hackzone/tgl18-badge/README.md

# tgl18-badge
Tweakers Gaming Live has an awesome event badge you can use to turn everyday objects into a game controller! HackZone has designed and produced (by hand!) a badge for all LAN visitors.

## Information
Check out our [wiki](https://github.com/hackzone/tgl18-badge/wiki) for more information about your cool new badge!

#### Names & things
The Tweakers name and logo are registered trademarks of Persgroup Online Services, all rights reserved.
