hackzone/tgl18-badge/graphics/dxf/TGL18_Badge_full_circle_75.dxf

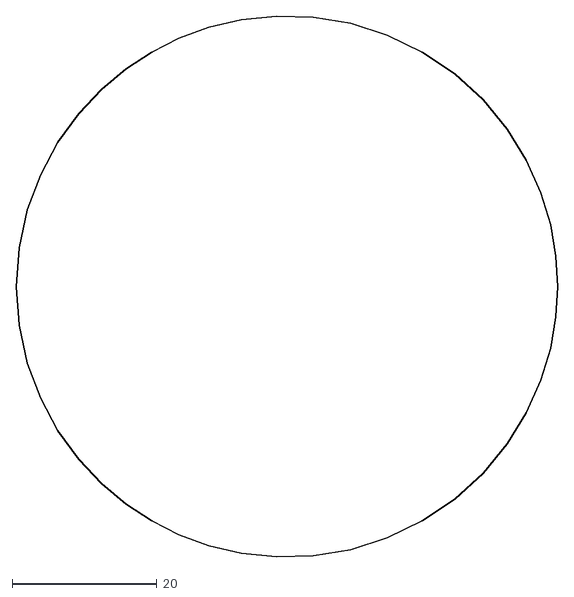
[picture p1: CAD file, 2018-10-01]
graphics/dxf/TGL18_Badge_full_circle_75.dxf
74.9 x 74.8
