hackzone/tgl18-badge/graphics/dxf/TGL18_Badge_full_circle.dxf

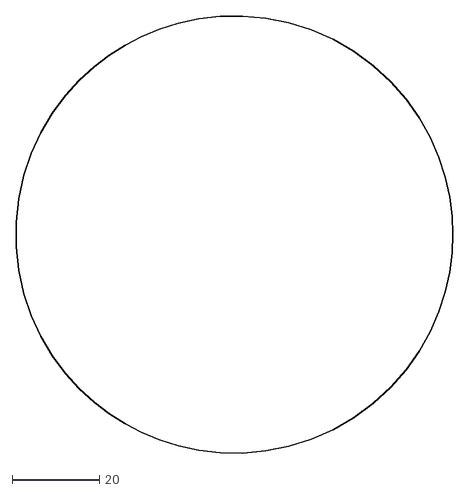
[picture p2: CAD file, 2018-10-01]
graphics/dxf/TGL18_Badge_full_circle.dxf
99.9 x 99.9
