hackzone/tgl18-badge/graphics/dxf/TGL18_Badge_T_75.dxf

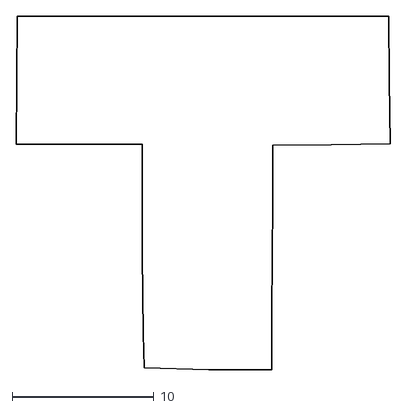
[picture p3: CAD file, 2018-10-01]
graphics/dxf/TGL18_Badge_T_75.dxf
26.3 x 24.9
