hackzone/tgl18-badge/graphics/dxf/TGL18_Badge_CU_75.dxf

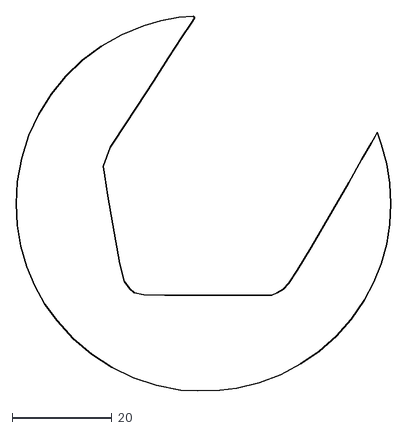
[picture p4: CAD file, 2018-10-01]
graphics/dxf/TGL18_Badge_CU_75.dxf
75.0 x 75.0
