hackzone/tgl18-badge/graphics/dxf/TGL18_Badge_T_Cutout.dxf

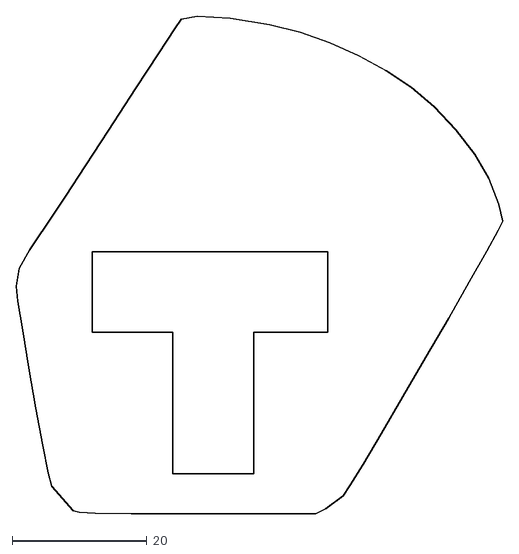
[picture p5: CAD file, 2018-10-01]
graphics/dxf/TGL18_Badge_T_Cutout.dxf
72.2 x 73.9
