hackzone/tgl18-badge/graphics/dxf/TGL18_Badge_CU.dxf

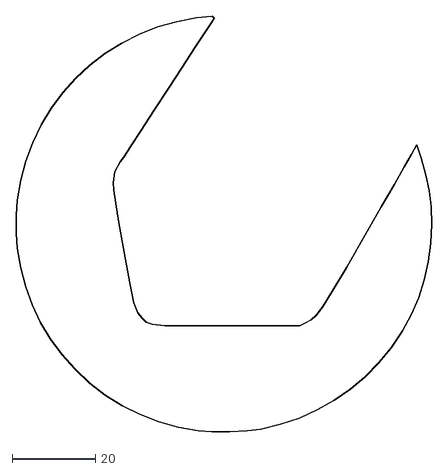
[picture p6: CAD file, 2018-10-01]
graphics/dxf/TGL18_Badge_CU.dxf
100.0 x 100.0
