hackzone/tgl18-badge/graphics/dxf/TGL18_Badge_Black_bit.dxf

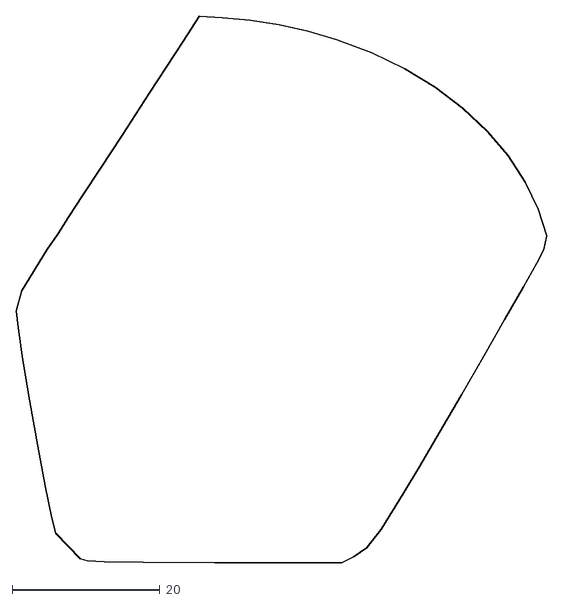
[picture p7: CAD file, 2018-10-01]
graphics/dxf/TGL18_Badge_Black_bit.dxf
71.8 x 73.9
