hackzone/tgl18-badge/graphics/dxf/TGL18_Badge_T.dxf

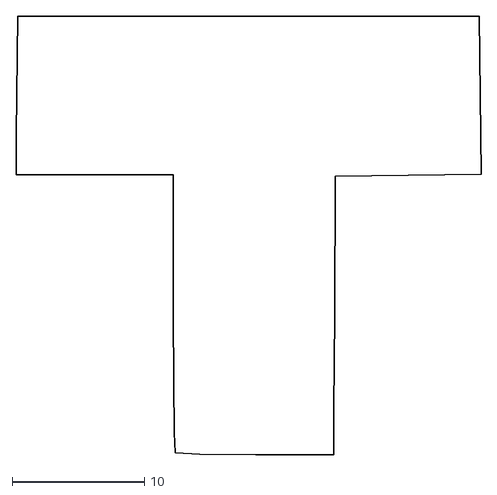
[picture p8: CAD file, 2018-10-01]
graphics/dxf/TGL18_Badge_T.dxf
35.1 x 33.2
