hackzone/tgl18-badge/(commit log)

2018-09-30 Added logic level converter and mpr121 schematics and layout
    [_saved_tgl18-badge.sch, tgl18-badge.kicad_pcb]
2018-09-30 Added preliminary aligator pads
    [tgl18-badge.kicad_pcb]
2018-09-30 Updated schematic w/ aligator pads
    [tgl18-badge.sch]
2018-10-01 Added DXF files
    [TGL18_Badge_Black_bit.dxf, TGL18_Badge_CU.dxf, TGL18_Badge_T.dxf, TGL18_Badge_T_Cutout.dxf, TGL18_Badge_full_circle.dxf, tgl18-badge.kicad_pcb]
2018-10-01 Updated pads
    [_saved_tgl18-badge.sch]
2018-10-01 Added Tweakers logo and outline to PCB design
    [tgl18-badge.kicad_pcb]
2018-10-01 Removed duplicate fill zone
    [tgl18-badge.kicad_pcb]
2018-10-01 Added 75 mm diameter graphics
    [TGL18_Badge_CU_75.dxf, TGL18_Badge_T_75.dxf, TGL18_Badge_full_circle_75.dxf]
2018-10-01 New placements
    [tgl18-badge.kicad_pcb]
2018-10-01 Rotated and moved cap pads to be aligned(ish)
    [tgl18-badge.kicad_pcb]
2018-10-02 Shortened and redistributed pads, added solder mask
    [tgl18-badge.kicad_pcb]
2018-10-02 Updated solder mask
    [tgl18-badge.kicad_pcb]
2018-10-07 Added explanatory text
    [tgl18-badge.kicad_pcb, tgl18-badge.sch]
2018-10-07 Added Defcon Shitty AddOn
    [tgl18-badge.kicad_pcb, tgl18-badge.sch]
2018-10-07 Fixed LLC footprint, turned badge name + howto into silk (safer for captouch)
    [tgl18-badge.kicad_pcb]
2018-10-07 Me being a persistend old fart added LEDS, again ;-)
    [tgl18-badge.kicad_pcb, tgl18-badge.sch]
2018-10-07 Me made booboo
    [tgl18-badge.kicad_pcb]
2018-10-07 Sort of doner I hope,
    [tgl18-badge.kicad_pcb]
2018-10-07 Zo beter.
    [tgl18-badge.kicad_pcb]
2018-10-07 Moved after Tom pointed out a much better spot.
    [tgl18-badge.kicad_pcb]
